dlepaux/pi5-runners/cad/assets/noctua/NF-A4x10.stl

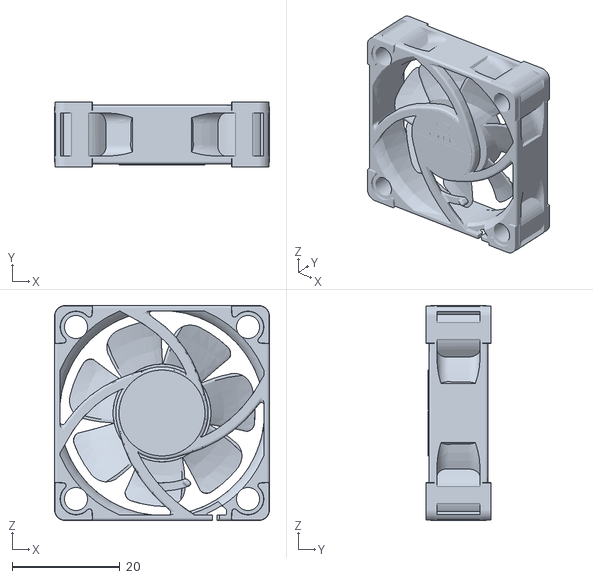
[picture p2: CAD file, 2026-09-18]
cad/assets/noctua/NF-A4x10.stl
40.0 x 12.0 x 40.0
