dlepaux/pi5-runners/cad/assets/noctua/NF-A4x20.stl

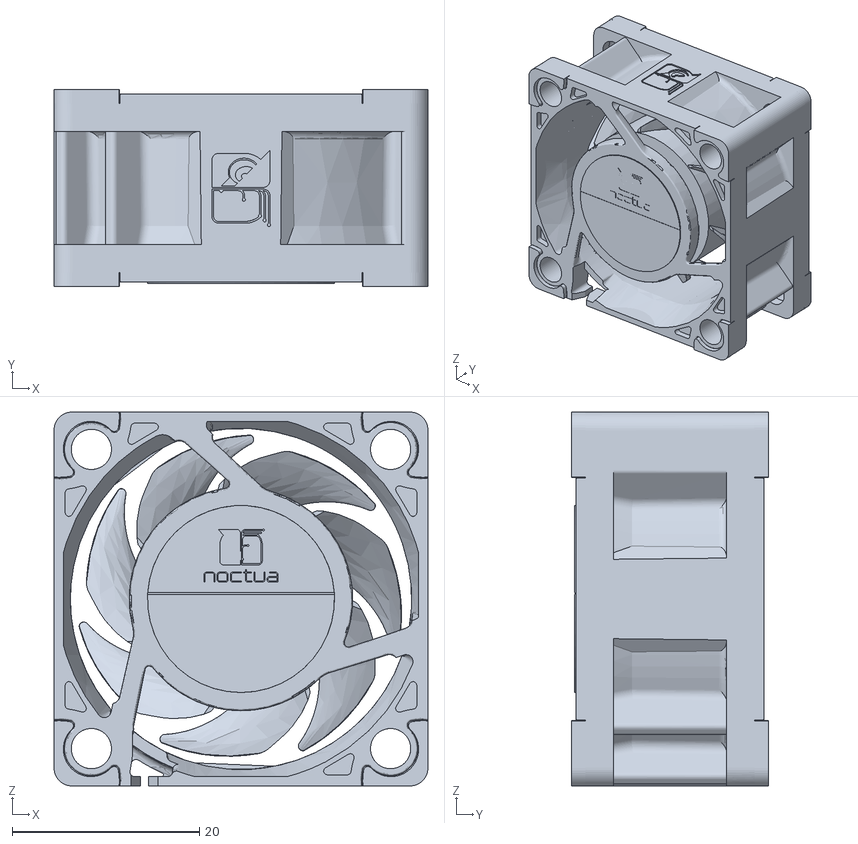
[picture p3: CAD file, 2026-09-18]
cad/assets/noctua/NF-A4x20.stl
40.0 x 21.1 x 40.0
