dlepaux/pi5-runners/cad/assets/noctua/NF-A8.stl

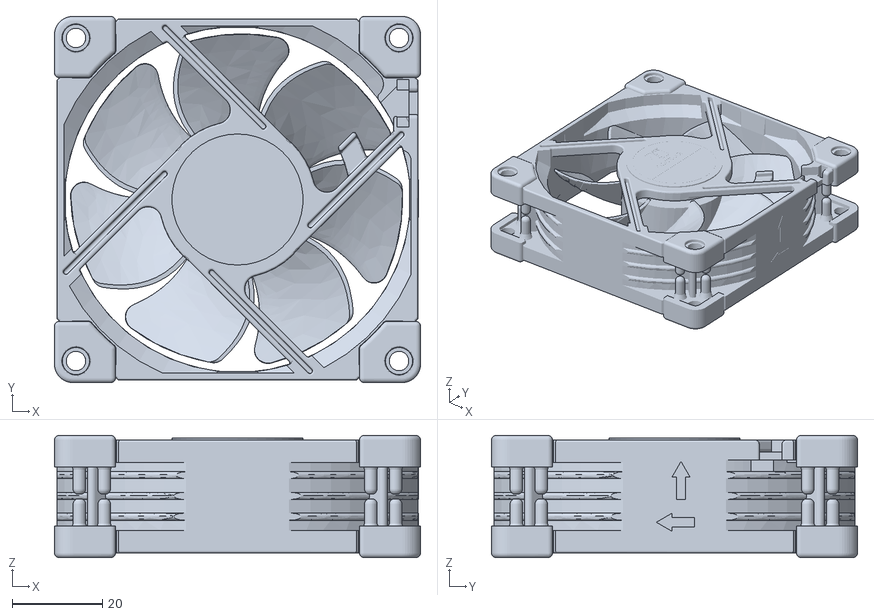
[picture p4: CAD file, 2026-09-17]
cad/assets/noctua/NF-A8.stl
81.0 x 81.0 x 27.0
