dlepaux/pi5-runners/cad/config.scad

// ============================================================================
// PI5-RUNNERS — CONFIGURATION
// ============================================================================
// Single source of truth for every dimension. Never hardcode in part files.
// Mirrors naja-miner/cad/config.scad, which mirrors lab-router's.
//
// THE CASE IS A STACK OF MODULES, ONE PI 5 AND ONE FAN EACH. Every module is the same
// printed part: a vented floor the Pi screws to, four walls, the fan on the inside of
// the front one. Its bottom is a SPIGOT that drops into the module below and clips
// there; a LID closes the top one. The boards are never connected to each other.
// Each module's front wall carries a round DUST FILTER with two flats, clipped into a
// recess over its fan.
//
// FRAMES. The MODULE frame: x=0 the front face, y=0 the -Y outer face, z=0 the bottom
// of the floor, which is the print bed. The STACK frame is module 0's; module k sits
// at z = k * module_pitch.
// ============================================================================

// The screw table, INCLUDED not used: `use` imports modules and functions but not
// variables, and the fastener block below reads its constants. It does not include
// config.scad, so there is no cycle. OpenSCAD does not hoist it, which is why it is
// at the top rather than beside the block that reads it.
include <lib/screws.scad>

EPS       = 0.01;     // CSG safety
OVERLAP   = 0.1;
tolerance = 0.4;      // general print fit
$fn       = 64;
wall      = 3;

// ----------------------------------------------------------------------------
// RASPBERRY PI 5
// ----------------------------------------------------------------------------
// Mirrors SBC_Model_Framework's rpi5 entry in sbc_models.cfg. The submodule can be
// updated under us; scripts/test-board-assets.sh is what notices if these drift.
pi5_pcb          = [85, 56, 1.65];
pi5_hole_pattern = [58, 49];
pi5_hole_inset   = 3.5;

// The Active Cooler's top, above the PCB's TOP face. Derived from the framework's
// rpi5_oem model, NOT measured on real hardware. It sets the Compact's custom standoff and
// therefore every module's height, so it is the first thing to re-measure if parts fight.
active_cooler_h  = 11.0;

// ----------------------------------------------------------------------------
// M.2 HAT+ — both variants
// ----------------------------------------------------------------------------
// From the official product brief RP-009234-MM, NOT from SBC_Model_Framework, which
// has no HAT geometry at all (grep it -- there is none).
hat_pcb_t            = 1.6;
hat_standard_size    = [65, 56.5];
hat_compact_size     = [71.5, 56.5];
hat_compact_header_w = 65;          // the Compact is 65 across its header edge

// The Compact is 6.5 WIDER than the standard and the difference is a tab on the -X
// side, hanging off the Pi's x=0 edge where the PCIe ribbon lands. It is not free:
// the module has to carry it, so its open front clears the tab rather than the
// board's edge. Confirm against the real part -- the brief's drawing does not resolve
// the tab's position, and this claims the worst case.
hat_compact_overhang_x = hat_compact_size[0] - hat_compact_header_w;   // 6.5

// The HAT's hole pattern IS the Pi's -- 58 x 49 at 3.5 -- which is what lets it stack
// straight up. Read pi5_hole_* rather than retyping 58/49/3.5: two features doing
// their own arithmetic on one datum will eventually disagree.
//
// In Y that makes the HAT 0.5mm DEEPER than the board it sits on: holes 3.5 from its
// near edge and 4.0 from its far one, so a 56.5 HAT over a 56 Pi overhangs the +Y
// edge by 0.5. The module must not be sized to 56.
hat_overhang_y       = hat_standard_size[1] - pi5_pcb[1];   // 0.5

// The supplied stacking header. THIS is the number that clears the Active Cooler, and
// it is the whole reason the standard HAT+ works over the cooler and the Compact does
// not: Raspberry Pi ship the standard one with a 16mm header and say outright that the
// Compact cannot take the cooler beneath it.
hat_stack_h          = 16;

drive_t              = 2.3;   // M.2 single-sided module
screw_head           = 2;     // supplied knurled double-flanged retaining screw

// Slot occupied height, measured from the board's PCB UNDERSIDE.
hat_slot_h  = pi5_pcb[2] + hat_stack_h + hat_pcb_t + drive_t + screw_head;  // 23.55
bare_slot_h = pi5_pcb[2] + active_cooler_h;                                 // 12.65

// The Compact's custom standoff is DERIVED, never typed: its only job is to clear the
// cooler the Compact was not designed to sit over. Landing on the same 16 as the
// standard HAT+ is not a coincidence -- both are set by the same cooler.
compact_standoff_h = hat_stack_h;
assert(compact_standoff_h >= active_cooler_h + 3,
       "the Compact's standoff must clear the Active Cooler by at least 3mm");

// Slot k's board. Every module is the same shape, so the slot only says what the
// preview puts in it -- and which envelope the fit tests check against the module.
slot_kind = ["standard", "compact", "bare"];   // bottom to top
function slot_h(k) = slot_kind[k] == "bare" ? bare_slot_h : hat_slot_h;

// ----------------------------------------------------------------------------
// FANS — one 40mm Noctua per module, 10 or 20mm deep
// ----------------------------------------------------------------------------
// ONE FAN PER PI. Each module carries its own fan on the inside of its front wall,
// screwed in from outside through the wall, the hexrack way,
// powered from its own Pi's GPIO 5V -- pins 2 or 4, ground on 6 -- so a module is a
// complete unit: board, storage, cooler, airflow. Three fans against the two a shared
// column had is +50% airflow.
//
// fan_model is the one mode switch. The fan sits between the front wall and the
// board, so it sets the MODULE's length -- and the lid's, which is the module's
// footprint. Switching fans means reprinting modules and lid; the dust filters are
// the same part either way. generate-stl.sh writes both.
//
// Depth is MEASURED off Noctua's STEP, never the datasheet's 10 or 20: the frames'
// anti-vibration pads stand proud of each face and the hub label stands proud of
// that. The hub diameter comes off the same label. Airflow, pressure and noise are
// the 5V datasheets'.
//
// NF-A4x10 5V: 8.2 m3/h -- NOT 4.85, which is its CFM figure read as m3/h and once
// wrongly ruled these fans out. 3-pin, no USB adaptor.
// NF-A4x20 5V: +15% airflow, +27% static pressure -- the number that counts behind a
// filter. Worth a couple of kelvin, not a different class of cooling.
//
//   name,        depth, hub, asset,                          extent (native, axis Y),  m3/h, mmH2O, dB(A)
fan_models = [
  ["NF-A4x10", 12.0, 16, "assets/noctua/NF-A4x10.stl", [40.0, 12.0, 40.0], 8.2, 1.78, 17.9],
  ["NF-A4x20", 21.1, 20, "assets/noctua/NF-A4x20.stl", [40.0, 21.1, 40.0], 9.4, 2.26, 14.9],
];
fan_model = "NF-A4x10";

fan_row = [for (r = fan_models) if (r[0] == fan_model) r][0];
assert(!is_undef(fan_row), str("unknown fan_model: ", fan_model));

fan_depth        = fan_row[1];
fan_hub_d        = fan_row[2];
fan_asset        = fan_row[3];   // relative to cad/: import() it only from a file IN cad/ -- see noctua-fan.scad
fan_asset_extent = fan_row[4];
fan_asset_tol    = 0.6;

fan_size       = 40;
fan_bolt_pitch = 32;
fan_clear      = 2;      // fan frame to the floors below and above: its silicone corner pads

// A ROUND BORE, NOT A SQUARE OPENING: a square as big as the fan removes the wall
// exactly where its corner screws go. 38, less a boss round each screw (fan_boss_r).
fan_bore_d  = 38;
// The blades' tips, measured off Noctua's STEP: 17.41 (NF-A4x10) and 17.57 (NF-A4x20).
// The bore may close in on its corners down to here without shading a blade.
fan_tip_r   = 17.6;

// The bosses take ~2.5% of it, left in: the exhaust check errs on the safe side.
fan_throat_area = PI * pow(fan_bore_d, 2) / 4 - PI * pow(fan_hub_d, 2) / 4;   // per fan

// ----------------------------------------------------------------------------
// CLIPS — hexrack's 45-degree rib into a groove
// ----------------------------------------------------------------------------
// The same joint as hexrack's dust filter: a square-section rib turned 45 degrees,
// half of it standing proud of one part, dropping into a matching groove in the
// other. The DIAMOND is the dust filter's now, two per filter; the modules' lap
// clips are half of it, sized by lap_rib below, clip_rib_len long.
// THE FILTER'S IS 20% UNDER HEXRACK'S 1.7, the owner's call for a lighter look. A 40%
// smaller rib (1.0 x 11) was once tried on the module joints and printed too small;
// 20% on a clip that only holds a filter ring is not that.
clip_rib     = 0.8 * 1.7;    // hexrack's dust_clip_length, less 20%: the rib's square section
clip_clear   = tolerance;    // groove stands this far off the rib all round
clip_rib_len = 18;           // the lap clips' length

rib_half    = clip_rib * sqrt(2) / 2;                        // proud of the joint plane
groove_half = (clip_rib + sqrt(2) * clip_clear) * sqrt(2) / 2;

// ----------------------------------------------------------------------------
// STACKING — one 45-degree lap on all four walls, a clip on each
// ----------------------------------------------------------------------------
// NO SPIGOT. A module's walls end below in a 45-degree CHAMFER across their whole
// thickness, low at the inner face and high at the outer one; the module below ends
// its walls in a BEVEL of the same slope. The chamfer lies on the bevel on all four
// sides -- the front too, now -- so it carries the weight and centres each module on
// the one below. The lower wall rises into the V as a LIP, so the outer faces meet
// flush. Nothing on it prints over air: floor-down, the chamfer is a 45-degree
// overhang all the way out to the outer face.
//
// THE CLIP IS ON THE LAP: HALF OF THE OLD '>'. Seen end-on, the old rib stood out of
// its wall as a '>'. On the lap it keeps that '>' as the world sees it, and only its
// UPPER half: a triangle with a flat underside, a face falling outward at 45 (the
// '>''s upper stroke, the face that holds, at lap_clip_angle), and its third side on the
// chamfer. Male on the module's underside, female in the bevel below -- the groove is
// the same triangle grown clip_clear all round. Pushed down, the flat underside rides
// the bevel and spreads the walls; pulled up, the holding face resists. Every face
// lies on the bed or at 45 or steeper, so both print. One per wall: four.
//
// WHERE ON THE LAP. The bevel below is a wedge, thin toward the outer face, and the
// groove runs lap_rib_w + clip_clear out from the rib's inner corner. That corner
// sits lap_z0 in from the wall's inner face so the groove leaves lap_clip_wall of wall
// outside it -- and as low, on the bed: the chamfer is carried on down to it, so the
// floor narrows to the rib's corner with no step.
// THE LIP STOPS ONE EXTRUSION LINE WIDE, not at a knife edge. A tip thinner than the
// nozzle's line is dropped or printed ragged by the slicer and chips in handling; at
// 0.4 it prints as one clean line and leaves a 0.4mm hairline at the joint.
lip_t      = 0.4;
// The chamfer's clearance off the bevel, along its normal. Nominal only -- the print's
// own tolerance swallows it, so the bevel bears -- but two coincident slanted faces
// are what a mesh boolean cannot resolve: at zero the fit tests read noise as overlap.
lap_gap    = 0.05;
lap_sink   = lap_gap * sqrt(2);   // the bevel below the chamfer, vertically

lap_rib        = 1;    // the lap clip's height; the filter's diamond is clip_rib
// The holding face, from horizontal. 45 is the old '>'; steeper lets go more easily,
// and in the groove it is a gentler overhang.
lap_clip_angle = 60;
lap_rib_w      = lap_rib * (1 + 1 / tan(lap_clip_angle));   // on the bed
lap_clip_wall  = 0.7;  // groove to the lower wall's outer face, at least
// THE HOLDING FACE FITS CLOSE. The groove stands clip_clear off the rib everywhere
// else, but off the face that holds only lap_hold_clear: at 0.4 there, a module lifted
// 0.8mm before its clips took it -- a stack that rattles -- and the walls had only
// ~0.3mm to spring to let go. Square to a face at lap_clip_angle, a gap g is
// g / cos(angle) of lift.
lap_hold_clear = 0.1;
lap_clip_play  = lap_hold_clear / cos(lap_clip_angle);   // lift before the clips hold
lap_z0         = max(0, lap_rib_w + clip_clear - (wall - lap_clip_wall));
lap_top       = lap_z0 + wall;    // where the chamfer reaches the outer face
// The groove's floor, under the bevel's inner edge: the rib's flat underside, and
// clip_clear.
lap_groove_drop = lap_z0 + clip_clear;
assert(lap_rib < wall, "the lap rib's apex stands past the wall");
assert(lap_clip_angle >= 45 && lap_clip_angle < 90, "the holding face must print (>= 45) and hold (< 90)");
assert(lap_clip_play <= 0.25, "the lap clips let a module lift over 0.25mm before they hold");

// ----------------------------------------------------------------------------
// DUST FILTER — a round ring with two flats, one per module
// ----------------------------------------------------------------------------
// hexrack's filter, reshaped: a CIRCULAR ring cut by flats left and right only, that
// sits FLUSH in a recess in the module's front wall. Fabric is glued into a 0.32mm
// pocket on its back reaching 4mm out from the window; two 45-degree ribs on the
// side flats, running vertically at the ring's back, click into grooves in the recess.
//
// WHY A CIRCLE, NOT hexrack's HEXAGON. The ring must cover the fan's corner screws,
// which sit on the DIAGONALS. A hexagon with flats top and bottom has its points on
// the horizontal, so it came 59.4mm wide and left 2mm of front face each side -- no
// room for rounded corners (corner_r). A circle over the same heads is 53.8 wide.
//
// THE FLATS ARE THE CLIP SEATS, AT THE SIDES, and the only ones. They sit just past the
// glue pocket, and on the sides the clips read as part of the ring's outline rather
// than as caps on it. Above and below, the ring is round: standing in the module, the
// recess's crown is an arch 4mm deep off the web behind it, steeper than 45 within 45
// degrees of its top (test-print.sh budgets it). It once had flats there too, while
// the fan sat low; centred, the module is made tall enough for the round ring
// (module_headroom).
//
// THE RING COVERS THE FAN SCREWS. They go in from outside, countersunk into the
// recess floor, so the ring is sized to lie over every head: a corner hole at (16, 16)
// sits 16*sqrt(2) = 22.6 out, and its countersink reaches half its diameter further.
filter_depth     = 4;                    // ring thickness = recess depth
fan_web          = 3;                    // front wall behind the recess: what the screws pass
filter_clear     = tolerance / 2;        // ring to recess, all round: hexrack's
filter_glue_d    = 0.32;                 // hexrack's glue pocket depth
filter_glue_band = 4;                    // pocket reaches this far out from the window

// NOCTUA'S OWN SELF-TAPPING SCREWS, ~M5: the first prints were drawn for an M3, and
// every screw cut its thread through the web and cracked it (lib/screws.scad).
fan_screw    = "M5-Noctua";
fan_csink_d  = get_screw_spec(fan_screw, "countersink_diameter");
fan_screw_r  = fan_bolt_pitch / 2 * sqrt(2);                // a corner hole, from the centre
// THE HEADS SINK UNDER THE RECESS FLOOR, so the filter lies flat over them: the
// countersink starts this far down, under a counterbore its own width.
fan_screw_sink = 0.4;
// A BOSS ROUND EVERY SCREW. The holes sit 3.6mm outside the bore and the countersink is
// 3.75 in radius: bare, it broke into the bore. The bore gives up a crescent at each
// corner instead, and every countersink keeps three perimeters of web round it.
fan_boss_r   = fan_csink_d / 2 + 1.2;
assert(fan_screw_r - fan_boss_r >= fan_tip_r, "a screw boss shades the fan's blade tips");
assert(fan_screw_sink + (fan_csink_d - get_screw_spec(fan_screw, "through_hole_diameter")) / 2
         <= fan_web - 1,
       "the countersink leaves under 1mm of web under it");

filter_r_in  = fan_bore_d / 2;                              // the window frames the bore
filter_r_out = fan_screw_r + fan_csink_d / 2 + 0.5;         // the ring covers every head
filter_a_out = filter_r_in + filter_glue_band + 1;          // centre to a flat
filter_r_recess = filter_r_out + filter_clear;
filter_a_recess = filter_a_out + filter_clear;
filter_flat  = 2 * sqrt(filter_r_out ^ 2 - filter_a_out ^ 2);   // a flat's length
filter_rib_len = 0.8 * 0.6 * filter_flat;   // 20% under the 0.6 that cleared the arc

assert(filter_a_out < filter_r_out, "the flats miss the circle -- the ring has no flats");
assert(fan_bolt_pitch / 2 + fan_csink_d / 2 + 0.5 <= filter_a_out,
       "a flat cuts across a screw head");
assert(fan_csink_d / 2 < fan_web + filter_depth, "the countersink is deeper than the wall");

// ----------------------------------------------------------------------------
// FASTENERS — the Pi screws into its own module
// ----------------------------------------------------------------------------
// FOUR PRINTED FEET, one under each mounting hole, the screw cutting its own thread in
// a pilot hole -- hexrack's M2.5-4 pilot, as its sbcMountingHoles() cuts it. No heat-
// set inserts, no bought standoffs: the first prints carried a Ruthex insert in a 9.2
// post and a 6mm male-female standoff on it, three parts doing one foot's job for a
// board that is screwed in once. The HAT's male-female standoffs thread through the Pi
// straight into the feet (a bare Pi takes an M2.5 screw).
//
// The feet run from the floor to the board's underside, so the board keeps its height
// and air still runs under it, between four feet. Each flares onto the floor on a
// 45-degree chamfer: the root is where a 6mm foot would snap, and floor-down the
// chamfer prints as a widening first few layers, never over air.
//
// POSTS, NOT hexrack's CANOES: the rails joining each row cost plastic and did
// nothing the posts do not.
m25_screw     = "M2.5-4";
pilot_d       = get_screw_spec(m25_screw, "pilot_hole_diameter");   // 2.42
post_d        = 6;     // the Pi's mounting pad is 6 across: the foot sits on it, no wider
post_chamfer  = 1.5;   // the 45-degree flare at the floor, outward
// Deeper than anything that threads in: a HAT standoff's male end or an M2.5 x 6 screw
// leaves ~4.4 past the 1.6 PCB, and an M2.5 x 8 6.4. A screw that bottoms out strips
// the thread it just cut.
pilot_depth   = 8;

assert(post_d - pilot_d >= 2 * 1.6, "under 1.6mm of wall round the pilot hole");

// ----------------------------------------------------------------------------
// MODULE — one Pi 5 and its fan, printed floor-down as one piece
// ----------------------------------------------------------------------------
// SIZED FOR THE TALLEST BOARD, so there is ONE module shape and any board goes in any
// slot. A bare Pi wastes height; three different modules would waste a reprint every
// time a board changes role.
floor_t       = 2.4;   // the vented floor: 12 layers at 0.2
post_h        = 11.5;  // the feet, floor to the board's underside
plenum_gap    = 3;     // fan's back face to the Compact HAT's tab
module_air    = 5;     // top of the tallest board to the next module's floor, at least

// REAR: THE PORTS COME THROUGH THE WALL, FLUSH WITH ITS OUTER FACE, like the official
// case's. They used to stop 3mm short of the wall on a guessed 3mm overhang, which put
// the RJ45 6.6mm and the USB-A stacks 7.9mm inside the case -- more than half a USB-A
// plug's 12mm shell, so a plug could not seat. The reach is MEASURED off the
// framework's rpi5, and test-fit.sh holds it there: the RJ45 stands 2.40 past the
// PCB's +X edge, the USB-A stacks 1.11, so flushing the RJ45 leaves the USB-A 1.3 in.
//
// THE PI SLIDES IN. With its jacks in the wall it cannot drop in from above: it goes
// down short of the wall and slides back into its holes, BEFORE its HAT, while the
// Compact's tab and the plenum leave room ahead of it. config.scad asserts that room.
rear_port_reach = 2.40;  // RJ45 face past the PCB's +X edge
rear_port_proud = 0;     // RJ45 face past the rear wall's outer face; negative recesses it
slide_clear     = 0.5;   // jacks to the wall's inner face while the Pi goes down
// THE PCB GOES INTO THE WALL TOO. 2.40 of RJ45 against a 3mm wall puts the PCB's last
// 0.6 in it, so the wall's inner face carries a slot for the edge, its roof at 45
// degrees so it prints. The slot is what the Pi slides back into.
pcb_slot_clear  = 0.3;   // round the PCB's +X edge, in the slot

// SIDES: THE PI IS CENTRED ACROSS THE MODULE, so its feet sit symmetrically on
// the floor -- the first print had them 2.5mm toward -Y and it read as a mistake. The
// Pi is located by its four screws, not by the walls. The cost is on -Y: its USB-C and
// micro-HDMI sockets now sit 3mm behind the wall instead of 0.5, and a USB-C plug's
// shell is ~6.5mm long -- check a plug seats on the next print. The HAT's 0.5 overhang
// on +Y is why that side is 0.5 tighter.
side_clear     = 3;     // -Y: board to wall
side_clear_pos = 2.5;   // +Y: HAT overhang to wall

// The front wall: the recess the filter sits in, and the web behind it the fan's
// screws pass through.
front_wall_t = filter_depth + fan_web;

// The Pi in the module frame: behind the front wall, the fan and the plenum. The
// Compact's tab hangs 6.5 off the PCB's -X edge, toward the fan, so the plenum is
// measured from the tab.
board_x = front_wall_t + fan_depth + plenum_gap + hat_compact_overhang_x;
board_y = wall + side_clear;
// THE BOARD STAYS ON THE FLOOR'S POSTS, whatever the headroom: that is room for a taller
// heatsink ON it. It used to rise onto the fan's axis (board_lift), which never fired
// until the fan was centred -- and then would have eaten 5mm of that room.
board_z = floor_t + post_h;   // the PCB's underside

module_l = board_x + pi5_pcb[0] + rear_port_reach - rear_port_proud;
// The jacks sit wall + rear_port_proud deep in the rear wall. Slid that far forward
// (and slide_clear more) to go down past it, the bare Pi's -X edge must clear the fan.
slide_travel = max(0, wall + rear_port_proud) + slide_clear;
assert(plenum_gap + hat_compact_overhang_x >= slide_travel,
       "no room ahead of the Pi to slide its jacks into the rear wall");
module_w = board_y + pi5_pcb[1] + hat_overhang_y + side_clear_pos + wall;
assert(abs(board_y + pi5_pcb[1] / 2 - module_w / 2) < EPS, "the Pi (and its feet) is not centred across the module");

// THE FOUR VERTICAL CORNERS ARE ROUNDED, for the look. Vertical, so it costs nothing to
// print. Every outline -- walls, floor, lap, bevel, lid -- is inset from the same
// rounded footprint, so the lap stays concentric round the rear corners. The front
// corners are what limit it: they pass beside the filter's recess, which at its widest
// leaves 5.3mm of front face each side.
corner_r = 4;

// FLOOR TO FLOOR: the tallest board or the fan, whichever needs more. It is the fan:
// the floor, 40mm and fan_clear either side.
//
// PLUS module_headroom, the owner's call: 10 at first, because a taller passive
// heatsink did not fit under the next module's floor; 12.4 since the fan is centred,
// because that is what the ROUND filter needs over Noctua's screw heads (filter_room
// below asserts it). The board stays down; the fan shares the headroom out.
module_headroom  = 12.4;
module_pitch_min = max(board_z + hat_slot_h + module_air,
                       floor_t + fan_size + 2 * fan_clear);
module_pitch     = module_pitch_min + module_headroom;
assert(module_headroom >= 0, "module_headroom cannot take height the board or the fan needs");
// The next module's floor stands at module_pitch, its chamfer's inner edge lap_z0
// higher; this module's bevel runs lap_sink under that, up to the lip, lip_t in from
// the outer face.
module_h     = module_pitch + lap_top - lap_sink - lip_t;

// THE FRONT LIP DOES NOT SPRING: a lap rib passes the lip below by pushing it 0.48mm
// out, and the front wall is 7mm solid below its lip, so the front clip is hooked in
// first, tilted, and the rear pressed down -- the side and rear walls give. A thinned
// band above the fan was tried; the corners it left solid held the lip anyway, and
// with the fan centred the band has no room.
//
// THE FRONT WALL'S INNER PART STOPS SHORT OF THE MODULE ABOVE: its top is the lap
// groove's floor, lap_groove_drop under the next module's floor, not that floor. Flush
// with it, it was a second seat beside the lap -- a print's tolerances picked which one
// bore, and the clips stopped short of seating -- and it closed the front groove's
// inner side, so the rib could not be hooked in from inside as on the other walls.
front_top = module_pitch + lap_z0 - lap_groove_drop;

// THE ROUND FILTER'S ROOM ON THE FRONT FACE: from where the front's chamfer reaches the
// outer face, up to the front wall's top, less filter_edge_wall of wall at either end.
// The ring and its clearance must fit in it.
filter_edge_wall = 0.6;
filter_room      = [lap_top + filter_edge_wall, front_top - filter_edge_wall];
assert(filter_room[1] - filter_room[0] >= 2 * filter_r_recess,
       "the round filter runs into the lap: module_headroom is too small for it");

// THE FAN IS CENTRED, across the module and up its front face: the owner's call -- it
// sat at the bottom of the front with the headroom all above it. Centred on the
// filter's room, where the round ring is tight; that is 0.1 above the middle between
// the floors. The board does not follow it up (board_z).
fan_yc = module_w / 2;
fan_zc = (filter_room[0] + filter_room[1]) / 2;

// BEHIND THE FILTER'S RECESS THE FRONT WALL'S TOP FALLS TO THE FAN'S TOP, the owner's
// call: its inside face ends where the fan's frame does, not at the next floor. Steep,
// ~73 degrees, so it passes front_web_min behind the recess's crown -- straight from the
// recess's back to the fan's top it left 0.24 there, under one extrusion line, and a
// pinhole there lets unfiltered air round the ring. It faces up: nothing to support.
front_web_min = 0.8;                           // two perimeters
front_foot    = fan_zc + fan_size / 2;         // where the fall meets the inside face
front_crown   = fan_zc + filter_r_recess;      // the recess's top, at the middle
front_fall_x  = filter_depth + front_web_min
                - (front_top - front_crown) * (front_wall_t - filter_depth - front_web_min)
                  / (front_crown - front_foot);   // where the fall leaves front_top
assert(front_fall_x >= filter_depth, "the front wall's fall cuts over the filter's recess");

// THE WINDOW IS A 45-DEGREE FUNNEL, DOWN TO THE FABRIC, so dust wipes out of it instead
// of packing into the corner a straight 4mm wall made with the fabric. It opens toward
// the room; at the fabric the window is still the fan's bore. With the ring round above
// and below, it runs full all the way round: the side flats still leave filter_land of
// front face beside it -- and the first layer on the bed.
filter_land   = 0.8;                            // two 0.4mm perimeters
filter_funnel = filter_depth - filter_glue_d;   // its depth, and its widening per side
assert(filter_a_out - filter_land >= filter_r_in + filter_funnel,
       "the funnel runs into a side flat: under filter_land of front face beside it");

module_count = 3;
lid_t        = 3;     // the lid's plate, above its lap
stack_h = module_count * module_pitch + lap_top + lid_t;   // floor of 0 to lid top


assert(module_pitch - (board_z + hat_slot_h) >= 3,
       "less than 3mm between a HAT and the next module's floor");
assert(fan_zc - fan_size / 2 >= floor_t + fan_clear - EPS, "the fan sits on the floor");
assert(module_w / 2 - filter_a_recess - corner_r >= 1,
       "corner_r cuts into the filter's recess: under 1mm of wall at the front corners");
assert(fan_size + 2 <= module_w - 2 * wall, "the fan is wider than the module's inside");
assert(board_y + pi5_hole_inset - post_d / 2 - post_chamfer >= wall + lap_z0,
       "a foot's chamfer would stand in the floor's band under the lap");
assert(post_h - pilot_depth >= 1, "the pilot hole would break through the floor");

// The Pi's connectors must cut through FULL wall, above the chamfer.
assert(board_z + 1.5 > lap_top,
       "a connector would land in the chamfer instead of the wall");

// ----------------------------------------------------------------------------
// VENTS — triangles on the floor, louvres on the walls
// ----------------------------------------------------------------------------
// FLOOR: hexrack's triangle lattice -- cell 14, web 1.6, corner 1.2, stagger 0.5. A
// triangle cannot rack, so the floor stays stiff at a high open fraction.
//
// WALLS: louvres on the sides and the rear, round the rear port cluster
// (lib/vents.scad).
//
// SIDE LOUVRES: vertical slots, each running through the wall at vent_side_angle
// toward the rear -- \\\ on +Y, /// on -Y seen from above. The air inside is already
// heading rearward, so it turns less to leave, and at 45 through a 3mm wall a 3mm slot
// has no line of sight to the board. NOT a Venturi effect: nothing outside moves air
// past the wall. The cost is their throat, sw * cos(angle) across the flow, which is
// what test-airflow.sh counts. Their flat tops are 3mm bridges.
vent_tri_cell    = 14;
vent_wall        = 1.6;
vent_tri_radius  = 1.2;
vent_tri_stagger = 0.5;
vent_margin      = 3;    // solid border round every field
floor_vents      = false; // the floor's triangle lattice: off, the floor is solid

vent_slot_w       = 3;     // side louvre's slot, along the wall
vent_slot_bar     = 2.5;   // the slat between two slots, along the wall
vent_side_angle   = 45;    // louvre's lean toward the rear, from the wall's normal
vent_side_share   = 1;     // how much of the room behind the -Y ports the louvres take

// EXHAUST: the rear wall and the rear of both side walls. Never the lid: a lid with
// holes drops dust straight onto the top board. Fields stay above the chamfer and
// below the socket's clip grooves.
vent_z0 = lap_top + vent_margin;
vent_z1 = module_pitch + lap_z0 - lap_groove_drop - vent_margin;


// The -Y connectors, measured off the framework's -Y mask: USB-C and the micro-HDMIs
// span 6.25..42.60 along the board, 1.53..6.02 up from the PCB's underside. The
// connectors themselves stand side_port_reach past the PCB's -Y edge -- measured off
// the framework too, and test-fit.sh holds it there.
side_port_cluster_x = [6.25, 42.60];
side_port_cluster_z = [1.53, 6.02];
side_port_reach     = 1.0;

// THE PORT ISLAND. The board is centred, which leaves its -Y connectors 2mm behind
// the wall's inner face and a plug 5mm to reach from outside: too far to seat. Round
// the cluster the wall steps IN, as a panel: its inner face island_gap off the
// connectors, its outer face island_t out from that -- a plug's reach halves, to 2.5.
// The connectors cannot go INTO the wall as the rear jacks do: the Pi goes in by
// being lowered and slid back, never sideways. The panel's top and bottom step in at
// 45 degrees, inside and out, so it reads as one sheared panel and prints: the outer
// recess's ceiling and the inner bulge's underside are 45-degree overhangs. Its ends
// step at 45 too, the owner's call: square, the chamfer ran round only two sides of
// the panel and read as unfinished. The rear one pushes the side louvres back.
//
// THE +Y WALL CARRIES THE SAME ISLAND, MIRRORED, WITH NO OPENINGS: the owner's call,
// for symmetry. The +Y edge has no connectors; its HAT overhang clears the bulge
// (test-fit.sh's slot checks hold it).
island_gap = 0.5;    // island's inner face to the connectors' faces
island_t   = 2;      // the wall in the island; 3 elsewhere
island_pad = 1.5;    // round the -Y port cluster, on the island's face
island_r   = 2;      // its corners, seen from outside
island_inner = board_y - side_port_reach - island_gap;   // y of the island's inner face
island_outer = island_inner - island_t;                   // y of its outer face
island_x = [board_x + side_port_cluster_x[0] - island_pad,
            board_x + side_port_cluster_x[1] + island_pad];
island_z = [board_z + side_port_cluster_z[0] - island_pad,
            board_z + side_port_cluster_z[1] + island_pad];

// The side fields sit behind the -Y connectors -- both sides, so the two walls match
// -- and against the rear wall, where the air leaves the board. They take only
// vent_side_share of that room: the full length read as too much opening.
// The louvres lean rearward by wall * tan(angle) from the inner face to the outer one:
// the room ends that much short, so the outer mouths keep vent_margin too.
vent_side_lean = wall * tan(vent_side_angle);
side_room_x  = [island_x[1] + island_outer + vent_margin,   // past the island's outer step
                module_l - wall - vent_margin - vent_side_lean];
side_field_x = [side_room_x[1] - vent_side_share * (side_room_x[1] - side_room_x[0]),
                side_room_x[1]];
assert(side_field_x[1] - side_field_x[0] > 3 * (vent_slot_w + vent_slot_bar),
       "the side exhaust field is too short to hold a grille");

assert(island_inner > wall && island_outer > 0,
       "the port island must step the wall in, not out");
assert(island_x[1] + island_outer < side_field_x[0] - 1, "the port island's step runs into the side louvres");
assert(island_x[0] - island_outer > front_wall_t + corner_r, "the port island's front step reaches the front wall");
assert(island_z[0] - island_outer > lap_top, "the port island's outer step reaches the lap");
assert(island_z[1] + island_outer < module_h - 3, "the port island's outer step reaches the bevel");

// EXCLUSION ZONE, hexrack's idea: the rear port cluster sits in clean solid wall with
// the lattice running round it. Sized from the MEASURED cluster -- the framework's +X
// mask spans Y 2.33..54.50 and Z 1.65..17.90 in the board frame.
exclusion_pad       = 1.5;
exclusion_cluster_y = [2.33, 54.50];
exclusion_cluster_z = [1.65, 17.90];
exclusion_w = exclusion_cluster_y[1] - exclusion_cluster_y[0] + 2 * exclusion_pad;
exclusion_h = exclusion_cluster_z[1] - exclusion_cluster_z[0] + 2 * exclusion_pad;
exclusion_r = 3;

// The PCB-edge slot, board frame: from the rear wall's inner face to past the PCB's
// edge, and its full height with the 45-degree roof. The exclusion zone takes it in
// too, or the slot's floor clips the tops of the louvres under it.
pcb_slot_x0    = module_l - wall - board_x;
pcb_slot_depth = pi5_pcb[0] + pcb_slot_clear - pcb_slot_x0;
pcb_slot_h     = pi5_pcb[2] + 2 * pcb_slot_clear + pcb_slot_depth;
assert(pcb_slot_depth < wall - 1, "the PCB slot leaves under 1mm of rear wall");

// ----------------------------------------------------------------------------
// TRAY — the Pi's feet on a plate of their own, clipped into the module's floor
// ----------------------------------------------------------------------------
// The Pi screws onto its four feet on a TRAY, on the bench, not 2.5mm off a wall
// inside the module. The tray is the feet's own outline: a rounded rectangle whose
// corners are concentric with the feet. It drops into a WINDOW of the same shape in
// the module's floor; the module keeps its walls, its lap and its clips.
//
// IT CANNOT FALL THROUGH: all four edges of the window are chamfered at 45, wide at
// the top, and the tray's edges match -- floor-down, the tray's edge is a 45-degree
// overhang and the window's looks up, so both print. A lap clip (the half '>') on
// each of the four sides holds it down.
//
// THE CLIPS NEED A SPRING. Tray and floor are both flat plates in one plane: neither
// gives sideways, so a rib between them could not pass. Each rib stands on a strip of
// the tray's edge, tray_strip wide, freed by a slot behind it between the feet -- the
// strip bends in as the tray goes down, as the module's walls do for its lap clips.
//
// HOW IT GOES IN: the jacks sit flush in holes in the rear wall, so the loaded tray is
// held tray_drop up, over the floor, slide_travel short of the rear wall; slid back,
// its jacks go into their holes; then it drops into its window and clicks.
//
// THE REAR HOLES ARE THE JACKS' OWN SIZE, the owner's call (rear_hole_rise = 0). They
// ran tray_drop taller so the jacks could go in at that height as rigid CAD; on the
// print that read as a 2.6mm gap over every jack, and the owner found the tray goes
// in without it. So the CAD path no longer proves the jacks' entry: boards-path holds
// them only down to the wall. rear_hole_rise is the knob if a print disagrees.
//
// Its edge stands island_inner + tray_clear in from each outer face: lowered from the
// top, it passes between the port islands, which stand 1.5mm into the cavity. That
// sets the corners' radius round the feet.
tray_gap    = lap_gap;                    // along the chamfer's normal, as on the lap
tray_clear  = 0.2;                        // where tray and module meet but do not bear
tray_r      = board_y + pi5_hole_inset - (island_inner + tray_clear);  // round each foot's axis
tray_drop   = floor_t + tray_clear;       // held this high, the tray slides over the floor
rear_hole_rise = 0;                       // the rear holes and the PCB slot, taller upward by this
tray_strip  = 3.5;                        // the clip's spring, at the tray's top face
tray_slit   = 1.2;                        // the slot behind it: three lines
tray_slit_end = 1;                        // a slot's end to the foot beside it

assert(tray_r >= post_d / 2 + post_chamfer + 0.2, "a foot's root overhangs the tray's edge");
assert(tray_r - tray_strip - tray_slit >= 0, "the slot behind a clip cuts a foot");
assert(tray_strip - floor_t >= 1, "the clip's strip is under 1mm on the bed");
assert(island_inner + tray_clear + floor_t - wall - (lap_rib_w + 2 * clip_clear) >= 1,
       "the tray clip's groove leaves under 1mm of frame on the bed");

// ----------------------------------------------------------------------------
// ASSEMBLY / PREVIEW
// ----------------------------------------------------------------------------
// Open cad/case.scad and set case_part:
//   "assembly" - everything, for looking at
//   "module" | "tray" | "lid" | "filter" - one printed part
case_part = "assembly";

// Explode distance: modules apart, lid up, filters forward. The
// boards travel with their modules -- each is screwed to its own floor.
//
// THE EXPLODE LIVES ONLY IN case.scad. placement.scad never reads it, so no fit test
// can measure an exploded position even by accident.
assembly_space = 20;

show_boards    = true;    // the Pi 5s, from the framework (cooler included)
show_hats      = false;    // both M.2 HAT+ boards and their drives
show_standoffs = false;    // each HAT's M2.5 standoffs
show_fan       = true;    // one fan mesh per module, of fan_model
show_filter    = true;    // the dust filters
show_case      = true;    // modules and lid

// Bambu A1. Every printed part has to fit.
bed = [256, 256, 256];
