dlepaux/pi5-runners/(commit log)

2026-09-17 docs: add pi5-runners design spec
    Three Pi 5 GitHub runners in one tower, cooled by a single NF-A8 5V PWM.
    The M.2 HAT+ Compact cannot take the Active Cooler as supplied, per Raspberry
    Pi's own product brief. Slot 2 raises it on custom standoffs to the 16 mm the
    standard HAT+ uses, which is the height that clears the cooler. The roof spot-fan
    is kept as the documented fallback rather than built.
    An 80 mm fan spans the whole board stack, so it presents a fresh-air front to all
    three slots at once. That deletes the side plenum and ~40 mm of case width the
    40 mm fans would have needed to approximate.
2026-09-17 docs: add pi5-runners CAD implementation plan
    Eight TDD tasks from skeleton to STL pipeline. Website and CI are deliberately
    deferred to a second plan: they add nothing the geometry can be checked against,
    and the two unresolved hardware questions are settled by a print, not a viewer.
    Mesh assets follow hexrack rather than naja-miner. hexrack prepares each asset
    offline into a closed manifold, declares its extents in config.scad and asserts
    the consumer fits — which is why gyroid-tunnels.stl can be subtracted to cut the
    vents at all. naja-miner's two-representations-plus-reconciliation suite only
    exists because its vendor meshes were never repaired; repairing once up front
    deletes that ma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
2026-09-17 feat: project skeleton, SBC framework submodule, board-constants test
    The framework is a submodule and can be updated under us. Without a check tying
    config.scad's declared Pi 5 geometry back to sbc_models.cfg, every fit test in the
    suite stays green while describing a board that no longer exists.
    The bbox assertion is not redundant with the volume one. A volume floor only
    catches an error large enough to move volume past it: 95x50 renders 7838mm3
    against a 7800 floor and passes, while being wrong by 10mm in the axis the case is
    built around. Only the extents check sees it.
2026-09-17 feat(hat): add M.2 HAT+ standard and Compact geometry
    SBC_Model_Framework has no HAT models, so both come from the official product
    brief RP-009234-MM. The Compact cannot take the Active Cooler as supplied;
    raising it to the standard HAT+'s 16mm stacking header is what clears it, and
    config.scad asserts that rather than trusting the number to stay put.
    Two guards, because they catch different things. The assert catches a standoff too
    short to clear the cooler. It cannot see a HAT placed at the wrong z, which renders
    and exports cleanly -- the geometric check is what reports that, at 13688mm3.
    Two findings from reading the drawing that the spec had wrong:
    - a 56.5 HAT over a 56 Pi overhangs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
2026-09-17 feat(placement): derive the board stack and the case envelope
    interior_h is derived from the stack rather than typed, so a slot that grows trips
    an assert instead of quietly pushing the top board out of the fan's swept height.
    Fan spans z 6.975..86.975 against a stack of 10..85.95 -- covered at both ends.
    Envelope drifted from the spec and the spec has been corrected rather than left to
    rot: X 95 -> 98.5 because the Compact HAT hangs 6.5 off the board's -X edge, Y
    97 -> 97.5 because a 56.5 HAT over a 56 Pi overhangs +Y by 0.5. 1.04 -> 1.081 L.
    slotSlab() is documented as the over-estimate it is. It answers 'does this foul its
    neighbour' and lies about everything finer -- notably the fan's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
2026-09-17 feat(fan): add NF-A8 mesh asset, prepared and asserted
    Follows hexrack rather than naja-miner: the mesh is generated by a committed script,
    config.scad declares what was generated, and test-assets.sh holds the two together.
    No second representation to keep in sync.
    fan_depth is 25.4, not the datasheet's 25. Measured off Noctua's own STEP: the AAO
    frame's anti-vibration pads stand 0.2 proud of each mounting face. A 25mm pocket sits
    the fan on its pads instead of on the wall.
    Fixed step-to-stl.py for current cadquery-ocp, which returns an unregistered
    Bnd_Box::Limits from Get(). CornerMin/CornerMax are stable. naja-miner carries the
    same latent break.
    Two traps caught live and written into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
2026-09-17 feat(shell): cut base, shell and roof from one shell solid
    One outer surface and one inner surface in the whole project, so the walls cannot
    disagree about where they are.
    The parts are checked in BOTH directions, because neither implies the other.
    Overlapping claims print two parts that cannot both be in the case; claims that
    leave a gap print a case with a band missing. Each renders, exports and counts one
    body either way. Verified by perturbation: a 1mm gap is caught as 1214mm3 of shell
    that no part owns.
    render() inside shellPanel() is not optional -- preview does not evaluate booleans
    and a panel later cut by ports and vents blows past OpenSCAD's normalisation limit:
    blank window, per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
2026-09-17 feat(case): add assembly view with explode and show_* toggles
    Mirrors hexrack's body_part / bodyAssembly_space pair, turned 90 degrees: hexrack
    stacks sections along Y, this case stacks along Z, so base goes down, roof goes up
    and each board fans out by its own index.
    THE EXPLODE LIVES ONLY IN case.scad. placement.scad never reads assembly_space, so
    no fit test can measure an exploded position -- structurally, not by defaulting.
    Fixes a frame bug found while wiring the ports: board_x/y/z and interior_* are all
    in the INTERIOR frame but onBoard() translated from the CASE origin, so the whole
    stack sat one wall-thickness off. Invisible for four tasks because every existing
    check compared int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
2026-09-17 feat(vents): triangle vents, square intake, port cuts and the filter
    Ports come from the framework's own IO mask, not a table of coordinates retyped
    here. Two problems had to be solved to use it: the mask is swept only ~7-10mm and
    this wall's outer face is 11mm out, so as published it leaves 2mm of solid PETG in
    front of every USB-C and HDMI; and sweeping it drags the +X connectors along, so
    each sweep is confined to the one wall it is for.
    THE FIRST BLIND-PORT TEST WAS WORTHLESS. It intersected the panel with the same
    mask that cut it, so it was empty by construction and passed with the sweep set to
    zero. The probe now takes the mask's silhouette along the wall normal and extrudes
    it from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
2026-09-17 feat(base): board bosses, feet, and the roof retainer
    Bosses are hulled onto a wafer, not stood on the floor: a cylinder tangent to a
    plane meets it along a line with zero contact area, and the union renders,
    previews correctly and exports as a plate plus four loose pucks.
    The retainer gets TWO posts, not four, and the cooler is why. The Active Cooler's
    58x40 footprint seated at the board's 3.5 inset covers both mounting holes at
    y=3.5 entirely; only the y=52.5 pair stands in clear air. The post positions are
    derived from cooler_footprint rather than listed, so a different cooler moves them
    instead of silently landing one on a fan.
    Fixes a real bug in the port probe. projection() flattens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
2026-09-17 feat: add STL pipeline, aggregate suite and bed-fit checks
    Parts render from cad/case.scad with case_part set -- the same entry point the
    assembly uses -- so a printed part cannot drift from how it is shown.
    Bed fit is an assertion now rather than something you find at slicing time, after
    the design has settled around a part that is 4mm too tall.
    All four parts render clean: base 104.5x103.9x17, shell x82, roof x22, filter
    88x88x5.5, against a 256 bed. Case is 104.5 x 103.9 x 99.95, 1.085 L.
2026-09-17 docs: correct three stale claims in CLAUDE.md
    The volume (1.04 -> 1.085 L), the cable comb that was dropped during Task 7, and
    the HAT edge described as flush with the Pi's when it overhangs it by 0.5 -- which
    is the number the fan plenum is measured from.
2026-09-18 feat: front intake, rear exhaust, hexrack lattice and exclusion zones
    Fan and filter move to the -X front, opposite the USB/Ethernet cluster, so air runs
    the board's full 85mm length and leaves at the port wall where the Ethernet PHY runs
    hottest. Crossing the 56mm width left the exhaust on a blank wall.
    The front wall must be >= 80 wide to carry the fan while the board is 56, so the case
    grows 1.085 -> 1.25 L. The board sits against -Y so USB-C and HDMI meet their wall;
    the spare width is a +Y side channel and cable route.
    Exhaust was asked for rear-only. Built and measured: the port clusters' exclusion
    zones take ~43% of the rear, leaving 57% of the fan's throat, and venting the whole
    re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
2026-09-18 feat(fans): two stacked NF-A4x20 5V PWM instead of one NF-A8
    The fans sit on the front wall, so the wall had to be as wide as the fan: the 80mm
    made the case 92mm wide around a 56mm board. Two 40s stacked are a 40x80 column --
    the same height, so it still faces all three slots and keeps the no-plenum
    guarantee -- but narrow enough that the board sets the width again. 1.25 -> 0.875 L.
    Chosen against the alternatives with datasheet numbers: the cost is cooling margin,
    ~12.7K case-air rise instead of ~4.3K, still ~12K under the HAT's 50C ceiling in a
    25C room. One NF-A6x25 kept more margin but could not face the whole stack; the
    two NF-A4x10s on hand would sit at the ceiling itself.
    Fan depth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
2026-09-18 feat(fans): use the owned NF-A4x10 5V pair, correct their airflow
    Two NF-A4x10 5V in the 40x80 column instead of buying NF-A4x20s.
    Corrects an error that ran through this project: the NF-A4x10 5V moves 8.2 m3/h
    (Noctua infosheet), not 4.85 -- 4.8 is its CFM figure, read as m3/h. That made every
    NF-A4x10 estimate ~40% too pessimistic, including the one that first sent the design
    to an NF-A8 and the one that ruled these fans out. Corrected: ~14.6K case-air rise,
    ~10K under the HAT's 50C ceiling in a 25C room; the NF-A4x20 pair buys ~2K more.
    Measured off the STEP: 12.0 deep overall (frame 11.0 with pads, hub label +1), hub
    16. 3-pin with no USB cable, so both take 5V from a Pi GPIO header. C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
2026-09-18 feat(case): split the shell into four clipped walls with a real dust filter
    The one-piece shell printed as a 94 mm standing tube with every opening on a
    vertical face. Four walls print flat, and hexrack's 45-degree rib-into-groove
    clip joins them to each other, to the base and to the roof with no screws.
    All 23 joints live in one table (clipJoints) that the ribs, the grooves and
    test-clips.sh all read, so a groove cannot drift off its rib unnoticed.
    The filter is now hexrack's: a flush ring in a front recess with fabric glued
    behind. Each fan gets its own round bore, because the square intake had left
    every fan screw hole over air.
    The tower screws into heat-set inserts in two rails that r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
2026-09-18 feat(case): rebuild as a stack of one-Pi modules with a sliding front face
    The four-wall shell kept the three boards in one screwed tower and needed seven
    parts that each printed awkwardly. One module per Pi -- the same part printed
    three times -- keeps the boards independent, lets any board go in any slot,
    and prints floor-down as an open box.
    Modules stack spigot-into-socket on a 45-degree lap instead of a step, so the
    wall above the inset spigot prints like any wall rather than as a ledge over
    air, and clip together on hexrack's rib. A lid closes the top. The front face
    slides down over vertical dovetails on every module's sides -- both parts print
    standing, so each dovetail is a plain p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
2026-09-18 feat(case): one fan per module, the dust filter as the whole front face
    A shared two-fan column fed three boards through a plenum and made the front
    face the widest, most complicated part. A 40 mm fan inside each module's front
    wall gives every Pi its own airflow from its own GPIO header -- three fans,
    +50% air -- and makes a module a complete unit.
    With the fans gone from the front, the front face is just hexrack's filter at
    full size: a flat panel with a window per fan and the fabric glued behind,
    sliding down over dovetails now on the modules' front faces. It prints flat
    with no support.
    The fan sets the module's height: every screw hole must clear the spigot band,
    or a screw long enoug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
2026-09-18 feat(case): hexrack's hexagonal filters per module, fans screwed from outside
    The filter panel and its dovetails made the front one more part to print and
    fit. hexrack's own dust filter -- a hexagonal ring flush in a recess, fabric
    glued behind, two 45-degree ribs -- now clips straight into each module's front
    wall. The fans screw in from outside the way hexrack's do, countersunk into the
    recess floor under the ring.
    The spigot carries three ribs instead of five and ends at its rib, the sides
    clear the board by 0.5 mm instead of 3, and the front walls butt-join so each
    filter lies wholly in its own module.
    The cost is height: the ring has to cover the screw heads, which on a 40 mm
    fan sit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
2026-09-18 ci: publish a download page for the parts to GitHub Pages
    The STLs only existed after a local render. A plain static page -- no Node,
    unlike hexrack's React site -- lists the module, the dust filter and the lid
    for each fan, plus a zip per fan, with sizes measured off the files it links.
    CI runs the full suite first, so nothing the tests reject gets published.
2026-09-18 fix(assets): import the fan mesh from cad/, where every OpenSCAD agrees
    The first CI run failed on the showcase: the 2026.09 OpenSCAD snap resolves a
    relative import() against the file containing it, not the main document as the
    2026.01 build does locally, so lib/noctua-fan.scad looked in cad/lib/assets/.
    The import now lives at the call site in case.scad and tests.scad, both in
    cad/, and fanVisualization() takes the mesh as a child.
2026-09-18 feat(module): lift the board onto the fan's axis
    The filter sets each module's height, leaving ~20 mm above the board. With
    the board on the floor the top of the fan's flow passed over the HAT instead
    of across the board. board_lift, by default, centres the tallest board on the
    fan's axis and grows the insert rails to match; -D board_lift=0 restores the
    floor position.
2026-09-24 feat(case): rounded look, flush roof-free lap, simpler vents and a base
    The first printed module was sound but boxy, and its underside sagged: the
    stacking chamfer stopped 1.3 mm short of the outer face and left a flat roof
    printed over air.
    - Lap: the upper chamfer now runs to the outer face and bears on the bevel
    below, so nothing on the joint prints over air. The lower wall rises into
    the V as a 0.4 mm lip (one extrusion line) so the faces meet flush.
    - Rounded vertical corners (corner_r = 4) from one footprint for every
    outline. hexrack's hexagonal filter left 2 mm of front face beside it, so
    the filter is now round with two flats: it covers the diagonal screw heads
    in less wi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
2026-09-25 feat(case): filter clips at the sides, room for the Pi on +Y
    - Filter rotated 90 degrees: its flats and clip ribs now sit left and
    right, where they read as part of the ring's outline rather than caps on
    it. The full circle now sets the module's height (+2.4 mm each, stack
    172 mm), and the recess's crown is a 4 mm-deep arc instead of a flat;
    the print budget accounts for the extra overhang. The narrower recess
    leaves 7.5 mm of front face beside it.
    - 5 mm between the HAT and the +Y wall (was 0.5): room for fingers, the
    fan leads on the GPIO header, and a board that grows. -Y stays at 0.5 --
    the USB-C and micro-HDMI sockets must sit at their openings or a plug's
    6.5 mm shell n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
2026-09-25 feat(module): stand each Pi on 5 mm standoffs, not on the rails
    The board sat straight on the printed rails. An M2.5 x 5 male-female
    standoff in each insert now carries it: air runs under the whole board,
    and the board no longer depends on the rail tops' print finish. The
    board keeps its height on the fan's axis; the rails stop 5 mm short of
    it (rail_top) and the HAT's standoffs thread through the Pi into the new
    ones.
    Tests: the rails must reach rail_top, and the standoffs (hex envelopes)
    must clear the module and stand on the rails -- the latter checked to
    fail with the rails 1.7 mm short.
2026-09-25 chore(case): restore the default explode spacing
    A local preview value (0) went out with the standoff commit; 30 is the
    documented default.
2026-09-26 fix(case): centre the Pi across the module and restore full-size clips
    The first print showed two problems.
    - The insert rails sat 2.5 mm toward -Y, which read as a mistake. The Pi
    is now centred across the unchanged 68 mm width (3 mm to -Y, 2.5 to +Y
    past the HAT overhang), and config.scad asserts it stays centred. The
    cost: the -Y USB-C and micro-HDMI sockets sit 3 mm behind the wall
    instead of 0.5, so a USB-C plug has to be checked on the next print.
    - The clips shrunk 40% in 33dd461 came out too small. Back to hexrack's
    1.7 x 18 rib. spigot_h follows the rib (4.2 -> 5.2), so the stack is
    1 mm taller, and the base skirt is now derived from spigot_h instead
    of a typed 5.5 th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
2026-09-28 feat(case): bring the Pi's ports flush through the rear wall
    The guessed 3 mm overhang left the RJ45 6.6 mm and the USB-A 7.9 mm inside
    the case, too deep for a USB-A plug to seat. The reach is now measured off
    the rpi5 model, the PCB edge sits in a 45-degree-roofed slot in the wall,
    and the Pi slides back into its holes before its HAT goes on.
2026-09-28 feat(case): let the fan, not the filter, set each module's height
    A full-circle filter made each module 55 mm tall for a 40 mm fan. The filter
    is now flat top and bottom, and the pitch is the floor plus the fan with 2 mm
    for its silicone corner pads: the stack drops from 173 to 147.4 mm.
    Also restores the preview defaults (boards hidden, NF-A4x10, explode 30):
    show_boards broke CI, whose newer OpenSCAD cannot find the framework's cooler
    DXF. Adds a pre-push hook that runs the suite.
2026-09-28 feat(module): stand each Pi on four round posts, not two rails
    The rails joining each row of holes cost plastic and held nothing the posts
    do not. With posts, the floor lattice runs between them and the air under
    the board is broken up rather than channelled along two walls.
2026-09-28 feat(module): side louvres leaning toward the rear
    The side exhaust becomes vertical slots sheared 45 degrees through the wall,
    so the air, already heading rearward, turns less to leave and nothing sees
    the board. They take the whole room behind the -Y ports; the airflow test
    now counts their throat, not their face.
2026-09-28 feat(case): one clipped 45-degree lap on all four walls, no spigot
    The spigot band existed only to carry the clips, and the front was a butt
    joint with no clip. Every wall now ends in the same chamfer lying on the
    bevel below, with a rib on each chamfer half-sunk into a groove in the bevel:
    square bars on a 45-degree face, so every face prints. The floor lattice
    becomes an option, off: a solid floor prints whole and drops nothing on the
    board below. The lid's bearing check now measures a rib-free body; with its
    ribs on, it passed on a lap standing 0.3 mm off.
2026-09-28 feat(module): rear louvres below the ports as well as above
    The rear read as vented only at the top. The same ten columns now run below
    the port cluster too, so they read top to bottom with the ports between;
    the minimum band drops to one slot width to let the 4.6 mm band in.
2026-09-29 fix(case): lap clips are the upper half of the old '>' again
    On the chamfer the square rib read as the clip turned 45 degrees. The rib is
    now the old clip's end-on '>' cut flat under its point: a 45-degree holding
    face and a flat underside on the bed, in a groove of the same shape.
2026-09-29 feat(case): smaller lap clips, 1.0 instead of the filter's 1.2
    The lap clip looked oversized on the chamfer. It gets its own size, lap_rib,
    so the filter's clip is untouched; the smaller groove also lets the lap sit
    0.4 mm lower, which gives the filter ring 1.5 mm instead of 1.1.
2026-09-29 feat(case): lap clips hold on a 60-degree face, not 45
    The 45-degree face held harder than a stack that gets opened needs. At 60 a
    module lets go more easily, and in the groove the face is a gentler
    overhang. The narrower rib now starts on the wall's inner edge.
2026-09-29 feat(case): drop the base, and shrink the filter clips by 20%
    The feet added a part and nothing the bottom module's own flat floor does
    not already do. The filter's diamond clip is the only one left at hexrack's
    full size; it reads heavy on the ring, so it comes down 20%, the lap clips
    untouched.
2026-09-29 feat(module): step the -Y wall in round the USB-C and micro-HDMI ports
    The centred board left those connectors 5 mm behind the outer face, too far
    for a plug to seat. A panel round the cluster steps in to 0.5 mm off them,
    2 mm thick, halving the reach to 2.5 mm; its top and bottom step at 45
    degrees so it prints, and it reads as a recessed island.
2026-09-29 fix(case): lap clips fit close on their holding face
    With 0.4 mm clear all round a module lifted 0.8 mm before its clips caught
    it, and the walls needed only ~0.3 mm of spring to let go: a stack that
    rattles and pulls apart. The holding face now fits at 0.1 mm, 0.2 mm of
    play, and the clip suite lifts every lap rib 0.3 mm and requires a bite.
2026-09-29 fix(ci): assembly checks render with the boards off, whatever the preview says
    show_boards=true, a preview toggle, was committed by accident and failed
    five CI runs: CI's OpenSCAD cannot find the framework's cooler DXF. The
    checks are about the case, so they pin the boards off themselves.
2026-09-29 chore: fix standoff height
2026-10-02 fix(test): pin LC_NUMERIC so the suites pass under a comma-decimal locale
    Under fr_FR, awk and printf do not read 933.4 as a number: printf prints 0
    and awk compares strings, so a healthy module was reported as choking its
    0mm2 fan. CI runs in C and never saw it.
2026-10-02 feat(filter): the window is a 45-degree funnel down to the fabric
    A straight 4mm wall makes a square corner with the fabric where dust packs
    and will not wipe out. The funnel opens toward the room and keeps the fan's
    bore at the fabric.
    It is clipped to the ring's outline less a 0.8mm land, because the ring is
    only 1.6mm wide at its top and bottom flats: full at the sides and corners,
    a straight wall with a short slope above and below.
2026-10-03 feat(module): 10mm of headroom, and a front lip that springs in it
    A taller passive heatsink did not fit under the next module's floor on
    srv-runner-1. module_headroom adds 10mm above the board and the fan, which
    both stay where they were: the fan is centred in the height it needs, not
    in the pitch, so the dust filter is the same part and only the modules are
    reprinted.
    The front clip never went in pressed straight down. A lap rib passes the
    lip below by pushing it 0.48mm out; the side and rear walls give, but the
    front was 7mm solid to its top under a solid floor. The lid's clip worked
    only because its lap is a hollow skirt. In the headroom the front wall now
    thins from the inside to 1.2mm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
2026-10-04 feat(case): centre the fan and round its filter, cut for Noctua's screws
    The fan sat at the bottom of each module's front with all ten millimetres
    of headroom above it. It is centred now, and the filter's ring is round
    above and below, with flats only at the sides, where its clips are.
    The fan screws were drawn as M3 flat heads, a placeholder never checked
    against the screws in the fans' bags: Noctua's ~M5 self-tappers, which
    the fans' 4.3mm corner holes take. Each one cut its own thread through a
    3.4mm hole, wedged its head in a 6.3mm countersink 0.5mm from the bore,
    and cracked the web. The hole is 5.3 now, the countersink a 90-degree
    cone sunk 0.4 so the filter lies flat over the heads,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
2026-10-04 fix(module): stop the front wall's inside short of the module above
    Its inner part rose flush with the next module's floor. That made it a
    second seat beside the lap, so whichever face printed high carried the
    module and the clips stopped short of seating; and it closed the inner
    side of the front groove, so the front rib slid in over it at zero
    clearance instead of hooking in from inside like the other three.
    It now stops at the groove's floor, 0.4mm under the next floor, and
    behind the filter recess falls steeply to the fan's top on the inside
    face. The fall keeps two perimeters behind the recess's crown: straight
    from the recess, it left 0.24mm there, a pinhole for unfiltered air.
2026-10-05 feat(module): print the Pi's feet, screwed straight into, instead of inserts and standoffs
    A Ruthex insert in a 9.2 post plus a bought 6mm male-female standoff was three parts
    doing one foot's job, for a board screwed in once. Each foot now runs from the floor
    to the PCB, Ø6 to sit on the Pi's mounting pad, with hexrack's M2.5-4 pilot hole --
    the one its pillars used, and held, before they moved to inserts. A 45-degree
    chamfer at the root keeps a slimmer foot from snapping off the floor, and prints
    floor-down without support.
    Bill of materials loses 12 inserts and 12 standoffs.
2026-10-05 feat(module): step the port island at 45 all round, and mirror it onto +Y
    Only its top and bottom were chamfered; the square ends read as unfinished. And the
    -Y wall alone carried it, so the two sides did not match: +Y now has the same island,
    uncut. The rear step reaches 2.5 further back on the outer face, so the side louvres
    start behind it -- 4.5 shorter, exhaust still 203% of the fan throat.
2026-10-05 feat(module): engrave each module with its runner's hostname, three variants
    A failed job names its runner; the label is how you find the box in the stack. The
    name rather than the RAM because the hostname is what every log and SSH session
    shows. Grenze Gotisch is vendored (OFL) since OpenSCAD silently falls back to its
    default font, and a test pins it. The cut is sheared so its ceilings fall at 45 into
    the wall: no new overhang, the print budget is unchanged.
    The modules stay one shape; `runner` only picks the name, and generate-stl.sh and
    the site now ship three per fan.
2026-10-07 feat(module): screw the Pi onto a tray that clips into a window in the floor
    Screwing a Pi and its HAT standoffs 2.5 mm off a wall inside a 58 mm box was hard
    to install and service. The Pi now goes onto a tray on the bench: the feet's own
    outline, 45-degree edges all round so it cannot fall through, and one lap clip a
    side, each on a slotted strip -- tray and floor are coplanar plates and neither
    would otherwise give for a rib to pass.
    The rear jacks sit flush in closed holes, so the tray goes in held over the floor,
    slides back into them, then drops; the rear holes, PCB slot and exclusion zone are
    2.6 mm taller for it, which costs ~10 points of rear exhaust (221%/195% of throat).
2026-10-07 feat(tray): engrave each tray with its Pi's RAM instead of the module's hostname
    With the Pis on trays, the RAM is what tells three boards apart on the bench, so
    each tray carries 2GB, 4GB or 8GB under it, larger and mirrored to read with the
    tray turned over. The side walls lose their hostname, and the three modules are
    one part again.
2026-10-08 feat(case): plain trays, and rear holes the jacks' own size
    Both are the owner's calls after the last print.
    The RAM engraved under each tray is gone: the three trays are one part
    again, so tray_ram, the vendored Grenze Gotisch and the label checks go
    with it, and the tray's bridge budget drops to zero.
    The rear holes ran 2.6mm taller so the jacks could enter them with the
    tray held over the floor. On the print that read as a gap over every
    jack, and the tray goes in without it, so rear_hole_rise is 0. As rigid
    CAD the raised jacks do meet the wall, so boards-path now holds the
    jacks only down the descent, short of the wall; their entry is the
    print's to prove. rear_hole_rise stays as the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
2026-10-20 feat(site): give the download page hexrack's look and a 3D part viewer
    The page was a bare file list, so it sold the design less well than hexrack's
    site sells that one. It now shares hexrack's type and colours, opens on the
    hologram loop, states the README's thermal figures, and lets a visitor turn
    any part in 3D before downloading it. A CSS-only picker shows the files for
    the chosen fan.
    It is still plain HTML written by bash: three.js is vendored and loaded only
    when a part is opened, and test-site.sh fails the build on a missing file or
    on any third-party request.
2026-10-20 docs: ready the repo for being public
    The repo went public, so what a visitor reads has to be current and must not
    point into private ones. The September spec and plan described the replaced
    shell-and-roof design and linked the private siblings; CLAUDE.md carries the
    current design, and the history keeps the originals. CLAUDE.md drops the last
    runner hostname and the relative links to private repos. The readme gains the
    hologram poster and a link to the download site, and stops describing the
    lap clip as the square bar it no longer is.
    The page now links to the source. test-site.sh drops outbound <a href> before
    its scan, since a link a visitor follows is not a third-party load; injected
    ex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
2026-10-20 refactor(site): drop the photo gallery hook
    The hologram loop and the 3D viewer show the case well enough that no photos
    are coming, so the empty-folder gallery was code nothing would ever exercise.
